nassim-saii/BAD-USB/Pic2.jpg

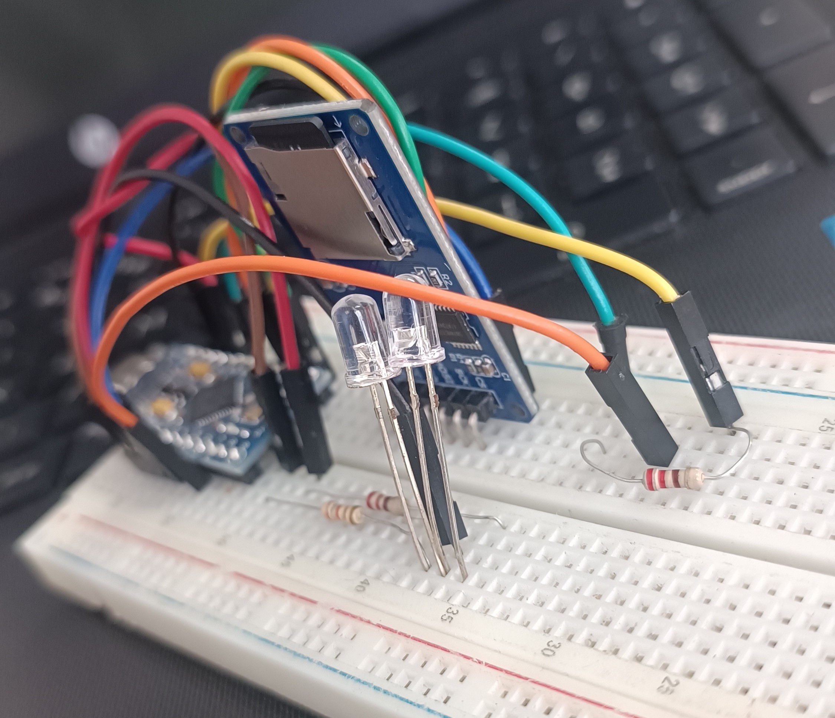
Pic2.jpg
