nassim-saii/BAD-USB/PICs/PCB-Back-View.png

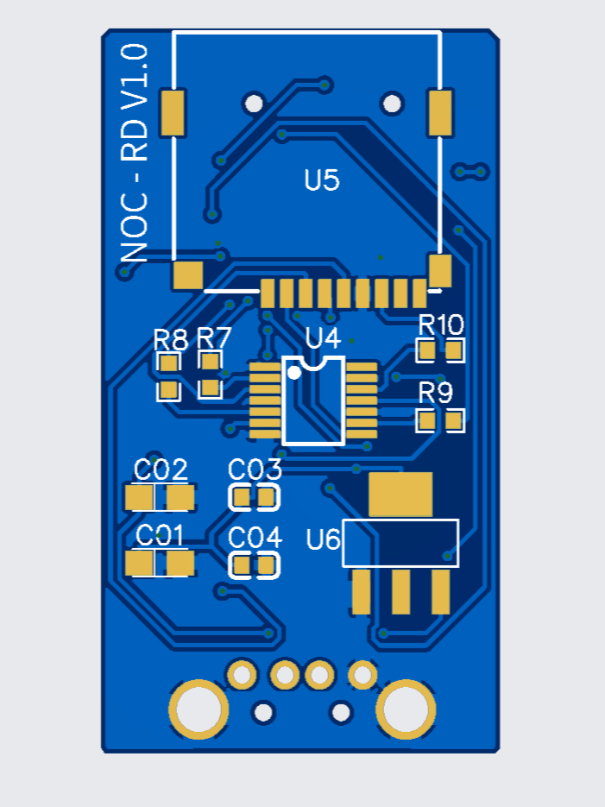
PICs/PCB-Back-View.png
