nassim-saii/BAD-USB/PICs/PCB-Front-View.png

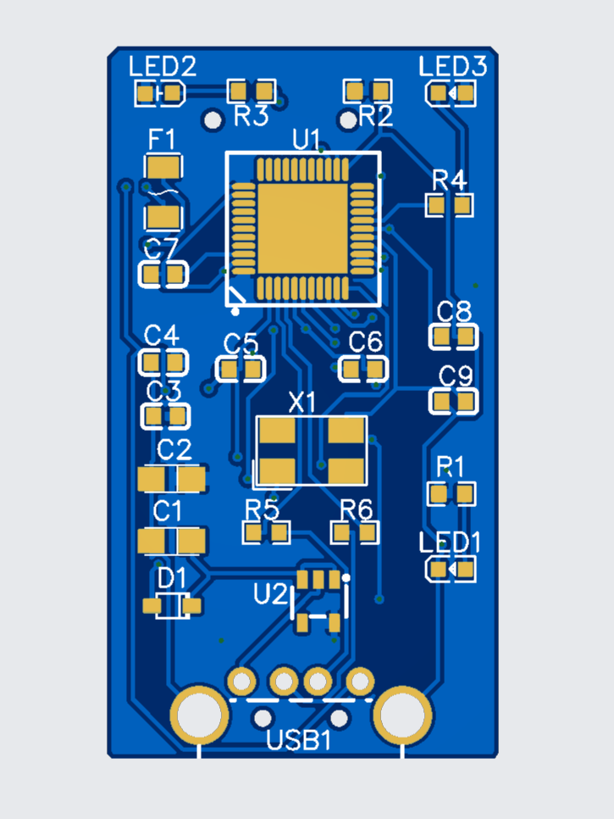
PICs/PCB-Front-View.png
