nassim-saii/BAD-USB/PCB/Build of Materials.csv

ID | Name | Designator | Footprint | Quantity | Manufacturer Part | Manufacturer | Supplier | Supplier Part | Price | Pins | 3DModel | Contributor | JLCPCB Part Class | link
1 | 10uF | C01,C02 | CASE-A_3216 | 2 | TAJA106K010RNJ | Kyocera AVX | LCSC | C7177 | 0.086 | 2 | CASE-A_3216 | lcsc | Extended Part | https://item.szlcsc.com/2057730.html
2 | 100nF | C03,C04,C4,C7 | C0603 | 4 | 0603F104Z500CT | TOPAZ(黄宝石) | LCSC | C180398 | 0.02 | 2 | C0603_L1.6-W0.8-H0.8 | LCSC | Extended Part | https://item.szlcsc.com/362304.html
3 | 3.3kΩ | R7,R8,R9,R10 | R0603 | 4 | 0603WAF3301T5E | UNI-ROYAL(厚声) | LCSC | C22978 | 0.001 | 2 | R0603 | lcsc | Basic Part | https://www.mouser.in/datasheet/2/447/PYu_RT_1_to_0_01_RoHS_L_11-1669912.pdf
4 | SN74LVC125APWRG3 | U4 | TSSOP-14_L5.0-W4.4-P0.65-LS6.4-BL | 1 | SN74LVC125APWRG3 | TI(德州仪器) | LCSC | C2675642 | 0.379 | 14 | TSSOP-14_L5.0-W4.4-H1.0-LS6.4-P0.65 | LCSC | Extended Part | https://item.szlcsc.com/8137.html
5 | HX TF-CARD H1.8 SY | U5 | TF-SMD_HX-TF-CARD-H1.8-SY | 1 | HX TF-CARD H1.8 SY | hanxia(韩下) | LCSC | C19189038 | 0.071 | 13 | TF-SMD_HX-TF-CARD-H1.8-SY | lcsc | Extended Part | https://atta.szlcsc.com/upload/public/pdf/source/20231103/DFFAA854C75C8DC1B66EF8C565790ADC.pdf
6 | AMS1117-3.3V | U6 | SOT-223-4_L6.5-W3.5-P2.30-LS7.0-BR | 1 | AMS1117-3.3V | WPMtek(维攀) | LCSC | C2688239 | 0.061 | 4 | SOT-223-4P_L6.5-W3.5-H1.6-LS7.0-P2.30 | LCSC | Extended Part | https://item.szlcsc.com/84517.html
7 | AM90 | USB1 | USB-AM-TH_AM90 | 1 | AM90 | SHOU HAN(首韩) | LCSC | C404965 | 0.066 | 6 | USB-AM-TH_AM90 | LCSC | Extended Part | https://atta.szlcsc.com/upload/public/pdf/source/20190722/C404965_9CC10BE28E3F9E5134758D030387C529.pdf
8 | 10uF | C1,C2 | CASE-A_3216 | 2 | TC212A106M016A | Sunlord(顺络) | LCSC | C97064 |  | 2 | CASE-A_3216 | lcsc | Extended Part | https://item.szlcsc.com/2057730.html
9 | 1uF | C3,C5,C6 | C0603 | 3 | 0603F105Z160CT | Huaxin S&T | LCSC | C302043 |  | 2 | C0603_L1.6-W0.8-H0.8 | LCSC | Extended Part | https://item.szlcsc.com/362304.html
10 | 22pF | C8,C9 | C0603 | 2 | CL10C220JB8NNNC | SAMSUNG(三星) | LCSC | C1653 | 0.004 | 2 | C0603_L1.6-W0.8-H0.8 | lcsc | Basic Part | https://item.szlcsc.com/362304.html
11 | DB2J20900L | D1 | SOD-323_L1.8-W1.3-LS2.5-RD | 1 | DB2J20900L | PANASONIC(松下) | LCSC | C278373 | 0.093 | 2 | SOD-323_L1.8-W1.3-LS2.5-RD | LCSC | Extended Part | https://item.szlcsc.com/295156.html
12 | nSMD050-13.2V | F1 | F1206 | 1 | nSMD050-13.2V | 台湾陆海 | LCSC | C70074 | 0.04 | 2 | F1206_L3.2-W1.7-H0.6 | lcsc | Extended Part | https://atta.szlcsc.com/upload/public/pdf/source/20200518/C553934_4CFF0660EAE88BF7A646763F248900C5.pdf
13 | FC-DA1608HRK-620D | LED1 | LED0603-RD_RED | 1 | NCD0603R1 | 国星光电 | LCSC | C84263 | 0.01 | 2 | LED0603-RD_RED | lcsc | Extended Part | https://item.szlcsc.com/221679.html
14 | FC-D1608UGK-520D10 | LED2 | LED0603-RD_1 | 1 | NCD0603G1 | 国星光电 | LCSC | C84267 | 0.016 | 2 | LED0603-RD_1 | lcsc | Extended Part | https://atta.szlcsc.com/upload/public/pdf/source/20240116/46ED3E15D55468D670A73973BFC834ED.pdf
15 | FC-D1608HYK-588J | LED3 | LED0603-RD | 1 | NCD0603Y1 | 国星光电 | LCSC | C84268 | 0.011 | 2 | LED0603-RD | lcsc | Extended Part | https://item.szlcsc.com/347874.html
16 | 1kΩ | R1 | R0603 | 1 | WR06X1001FTL | Walsin(华新科) | LCSC | C112433 | 0.001 | 2 | R0603 | lcsc | Extended Part | https://www.mouser.in/datasheet/2/447/PYu_RT_1_to_0_01_RoHS_L_11-1669912.pdf
17 | 10kΩ | R2 | R0603 | 1 | 0603WAJ0103T5E | UNI-ROYAL(厚声) | LCSC | C15401 | 0.001 | 2 | R0603 | lcsc | Extended Part | https://www.mouser.in/datasheet/2/447/PYu_RT_1_to_0_01_RoHS_L_11-1669912.pdf
18 | 330Ω | R3,R4 | R0603 | 2 | 0603WAF3300T5E | UNI-ROYAL(厚声) | LCSC | C23138 | 0.001 | 2 | R0603 | lcsc | Basic Part | https://www.mouser.in/datasheet/2/447/PYu_RT_1_to_0_01_RoHS_L_11-1669912.pdf
19 | 22Ω | R5,R6 | R0603 | 2 | 0603WAF220JT5E | UNI-ROYAL(厚声) | LCSC | C23345 | 0.001 | 2 | R0603 | lcsc | Basic Part | https://www.mouser.in/datasheet/2/447/PYu_RT_1_to_0_01_RoHS_L_11-1669912.pdf
20 | ATMEGA32U4-MU | U1 | VQFN-44_L7.0-W7.0-P0.50-BL-EP5.2 | 1 | ATMEGA32U4-MU | MICROCHIP(美国微芯) | LCSC | C112161 | 5.636 | 45 | VQFN-44_L7.0-W7.0-H1.0-P0.50 | lcsc | Extended Part | https://item.szlcsc.com/1427808.html
21 | MIC5219-5.0YM5-TR | U2 | SOT-23-5_L3.0-W1.7-P0.95-LS2.8-TL | 1 | MIC5219-5.0YM5-TR | MICROCHIP(美国微芯) | LCSC | C144182 | 0.964 | 5 | SOT-23-5_L2.9-W1.6-H1.1-LS2.8-P0.95 | LCSC | Extended Part | https://item.szlcsc.com/236104.html
22 | 16MHz | X1 | OSC-SMD_4P-L5.0-W3.2-BL | 1 | XVHCELNANF-16MHZ | TAITIEN(泰艺电子) | LCSC | C242216 | 0.465 | 4 | OSC-SMD_4P-L5.0-W3.2-H1.0 | LCSC | Extended Part | https://lcsc.com/product-detail/SMD-Crystal-Resonators_Yangxing-Tech-X503230MSD4SC_C26143.html
