nassim-saii/BAD-USB/PCB/Schematic_PCB-USB.pdf

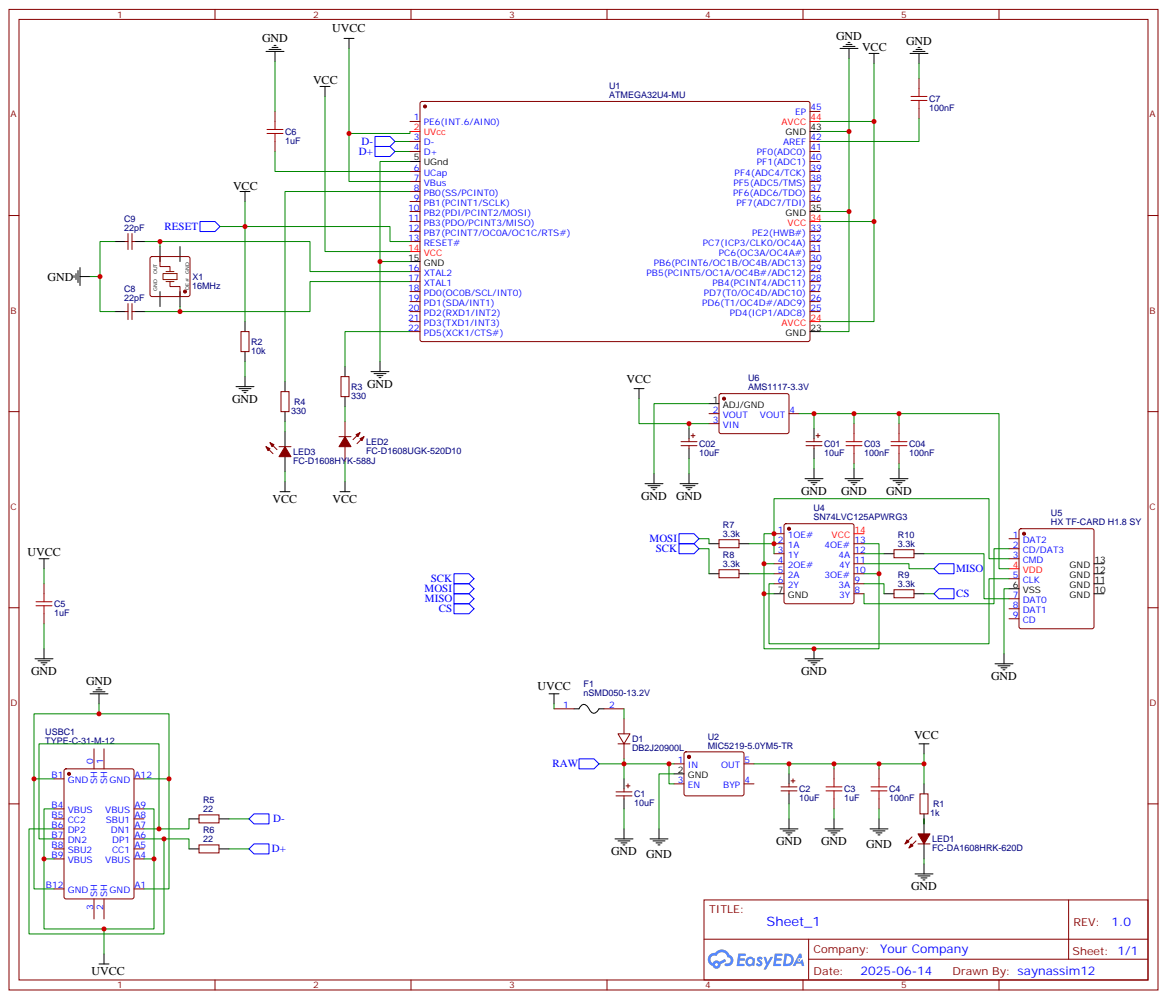
[picture p7: page 1]
